ffelipev2/CalidadAireEsp32S3Publico/(commit log)

2026-08-27 Publica firmware ESP32 y APK Android
2026-09-29 Documenta estructura del proyecto de calidad del aire
